Valentin-Auger-Laboratoire/support-telephone-decoupe-laser/plans/cale.png

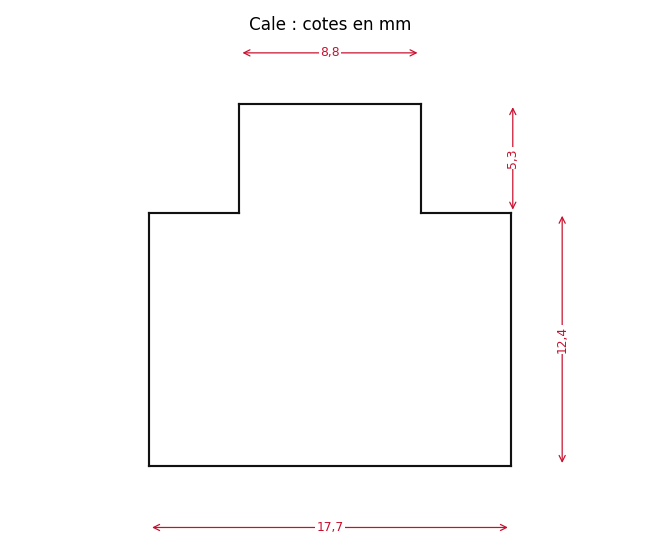
plans/cale.png
