Valentin-Auger-Laboratoire/support-telephone-decoupe-laser/plans/piece-encoches.png

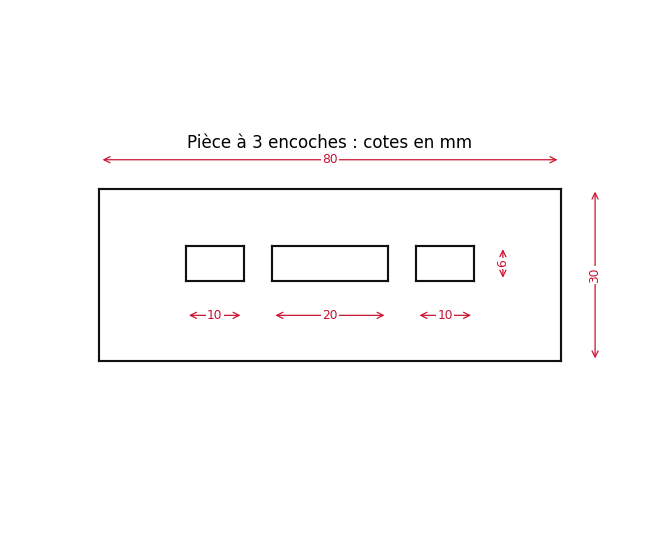
plans/piece-encoches.png
