Valentin-Auger-Laboratoire/support-telephone-decoupe-laser/plans/plaque.png

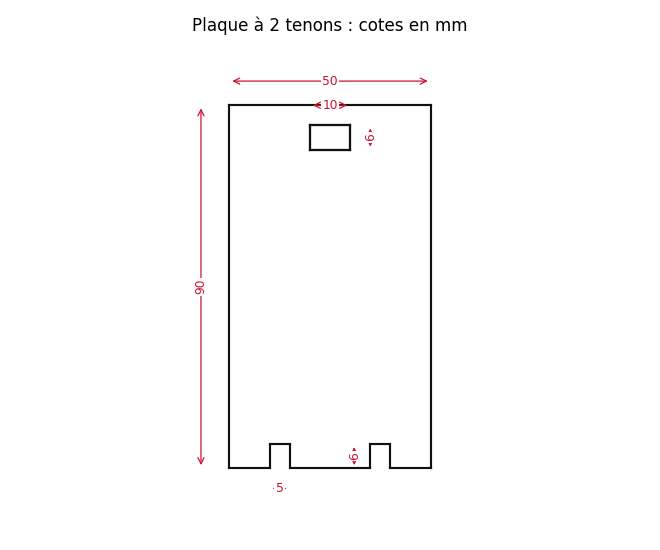
plans/plaque.png
