Valentin-Auger-Laboratoire/support-telephone-decoupe-laser/dxf/cale.dxf

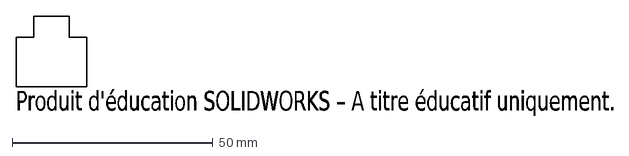
[picture p19: CAD file, 2026-11-05]
dxf/cale.dxf
Produit d'éducation SOLIDWORKS – A titre éducatif uniquement.
