Valentin-Auger-Laboratoire/support-telephone-decoupe-laser/dxf/plaque.dxf

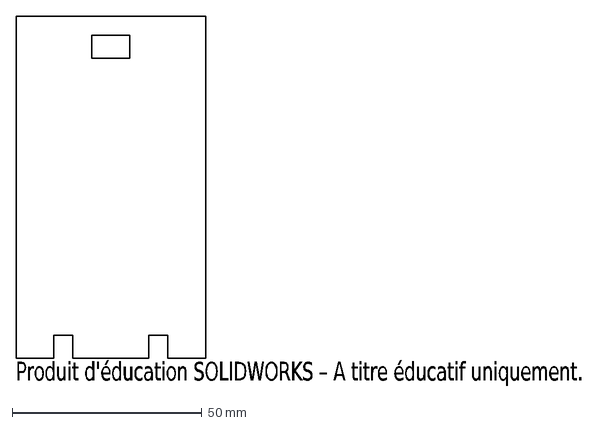
[picture p20: CAD file, 2026-11-05]
dxf/plaque.dxf
Produit d'éducation SOLIDWORKS – A titre éducatif uniquement.
