Valentin-Auger-Laboratoire/support-telephone-decoupe-laser/dxf/piece-encoches.dxf

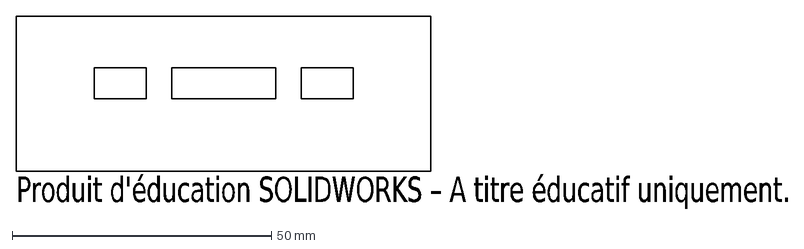
[picture p21: CAD file, 2026-11-05]
dxf/piece-encoches.dxf
Produit d'éducation SOLIDWORKS – A titre éducatif uniquement.
